kbeckmann/luna/hardware/rev0/luna_rev0.kicad_pcb

## KiCad design hardware/rev0/luna_rev0.kicad_pcb (2020-07-09)

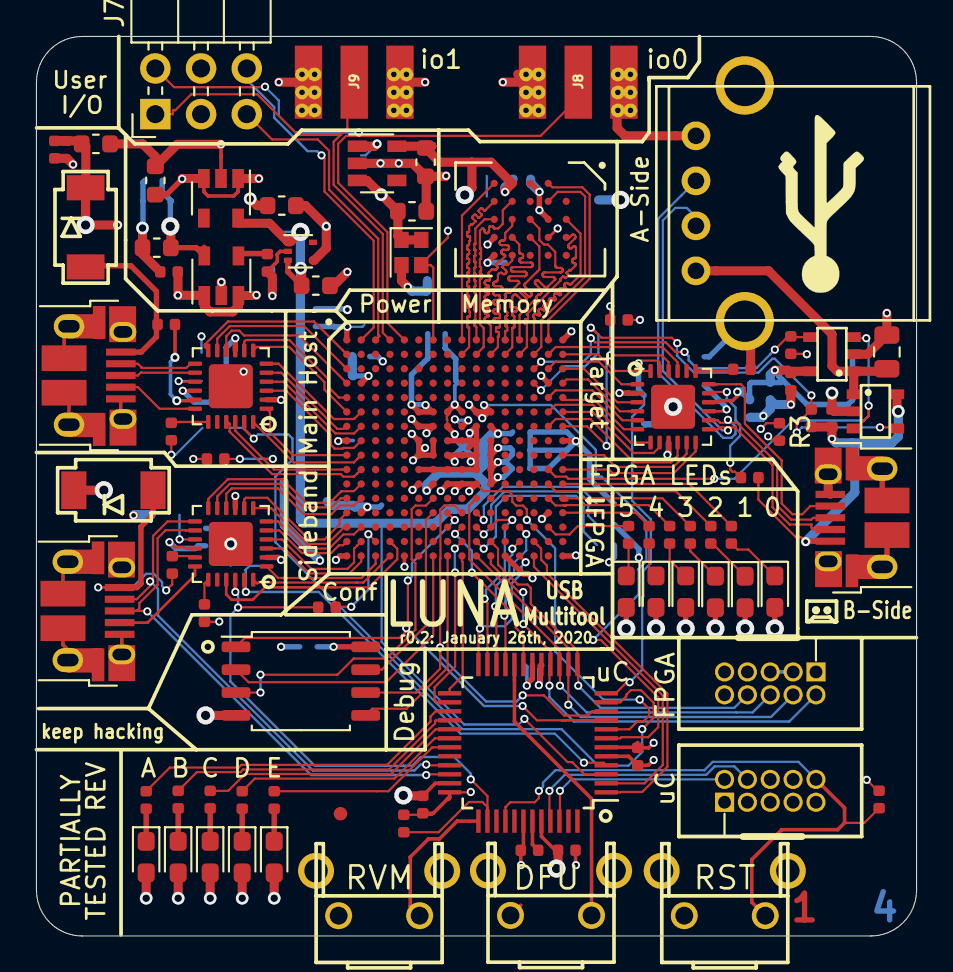
[picture p1: board luna_rev0.kicad_pcb from above]

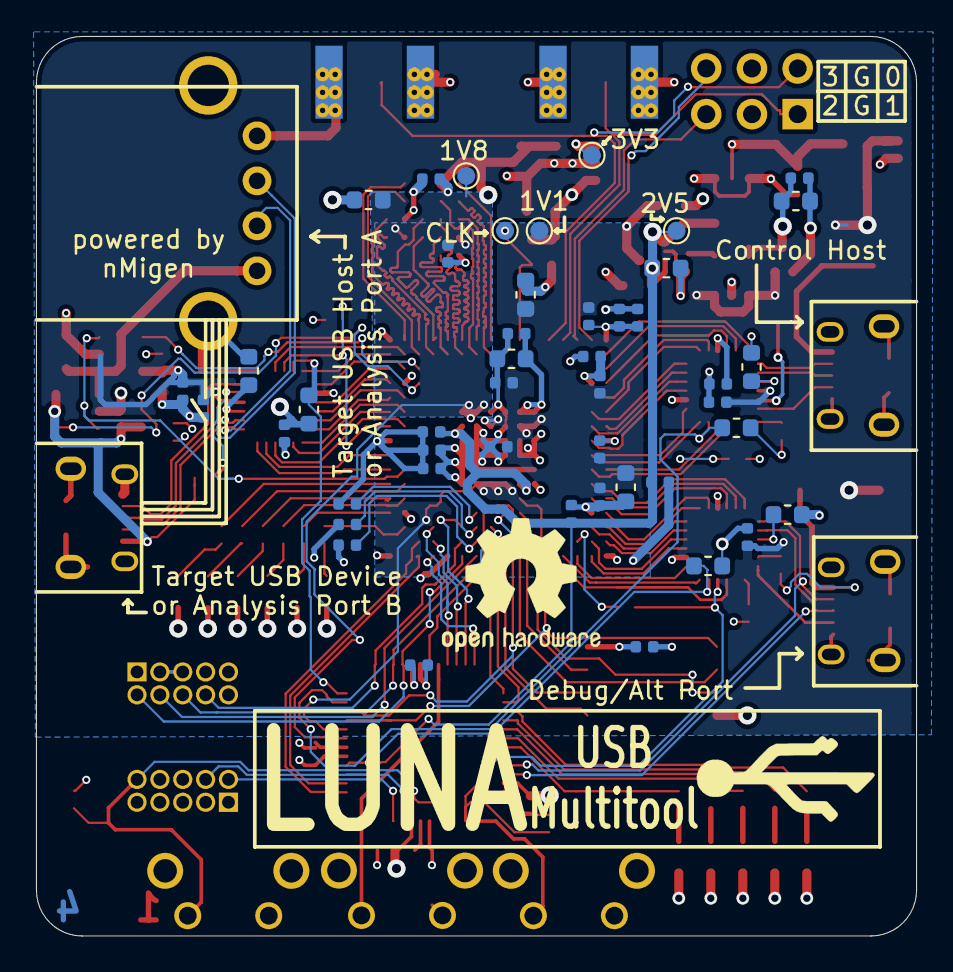
[picture p2: board luna_rev0.kicad_pcb from below]

Board: 4 copper layers, 48.9 x 50.0 mm, 128 parts (46 on the bottom side), 143 nets.

Parts:
C1, C2, C3, C4, C6, C20, C21: 2.2uF; C_0603_1608Metric
C5, C19, C22, C28, C29, C30, C36, C37, C42, C43, C48, C50: 1uF; C_0603_1608Metric
C7, C8, C9, C10, C11, C12, C13, C14, C15, C16, C17, C18, C23, C24, C25, C26, C27, C31, C32, C33, C34, C35, C38, C39, C40, C41, C44, C45, C46, C47, C49, C51, C54, C55: 0.1uF; C_0402_1005Metric
C52: 470pF; C_0402_1005Metric
C53: 10uF; C_0805_2012Metric
D1, D8: PMEG3050EP,115; SOD128
D2: RED; LED_0603_1608Metric_Pad1.05x0.95mm_HandSolder
D3: ORANGE; LED_0603_1608Metric_Pad1.05x0.95mm_HandSolder
D4: YELLOW; LED_0603_1608Metric_Pad1.05x0.95mm_HandSolder
D5: GREEN; LED_0603_1608Metric_Pad1.05x0.95mm_HandSolder
D6, D10, D14: BLUE; LED_0603_1608Metric_Pad1.05x0.95mm_HandSolder
D7: PURPLE; LED_0603_1608Metric_Pad1.05x0.95mm_HandSolder
D11, D13: PINK; LED_0603_1608Metric_Pad1.05x0.95mm_HandSolder
D12: WHITE; LED_0603_1608Metric_Pad1.05x0.95mm_HandSolder
FID: Fiducial_0.75mm_Mask2.25mm
IC1: ECP5-BGA256; lattice_cabga256
J1, J2, J4: USB_B_Micro; USB_Micro-B_Amphenol_10103594-0001LF_Horizontal
J3: USB_A; CONN-Amphenol-UE27AC54100
J5, J6: Conn_ARM_JTAG_SWD_10; SWD_CONNECTOR_LARGE_BOX
J7: Conn_02x02_Counter_Clockwise; PinHeader_2x03_P2.54mm_Horizontal
J8, J9: Conn_Coaxial; SMA-EDGE
R1, R2, R3, R12, R13, R14, R23, R24, R25: 10K; R_0402_1005Metric
R7, R8, R9, R10, R11, R26, R27, R28, R29, R30, R31: 330; R_0402_1005Metric
R15: 1K; R_0402_1005Metric
R16, R18, R20: 8.06k+1%; R_0402_1005Metric
R17, R19, R21: 20K; R_0402_1005Metric
R22: 15K; R_0402_1005Metric
SW1: BTN_RECOVERY; SWITCH-FSMRA
SW2: BTN_DFU; SWITCH-FSMRA
SW3: BTN_RESET; SWITCH-FSMRA
TP1, TP2, TP3, TP4, TP5: TestPoint; TestPoint_Pad_D1.0mm
U1, U12: AP22814-SOT; SOT25
U2: MIC5504-1.8YM5; SOT-23-5
U3: MIC5219-3.3YM5; SOT-23-5
U4: TCR2EE11; SOT-553
U5: MIC5504-2.5YM5; SOT-23-5
U6: ATSAMD21G18A-AUT; TQFP-48_7x7mm_P0.5mm
U7: W25Q32JVSS; SOIC-8_5.23x5.23mm_P1.27mm
U8, U9, U11: USB3343; VQFN-24-1EP_4x4mm_P0.5mm_EP2.45x2.45mm
U10: S27KS0641; BGA-24_5x5_6.0x8.0mm
Y1: DSC60xx; Crystal_SMD_2016-4Pin_2.0x1.6mm

Connections:
+1V1: C1.1, C3.1, C7.1, C9.1, C11.1, C13.1, C15.1, C17.1, C29.1, IC1.G6, IC1.G7, IC1.G9, IC1.L8, IC1.L9, IC1.L10, TP4.1, U4.4, U6.8
+1V8: C19.1, C21.1, C23.1, C25.1, IC1.F10, IC1.F11, TP2.1, U2.5, U6.7, U10.B4, U10.D1, U10.E4
+2V5: C22.1, C24.1, C26.1, C27.1, C30.1, IC1.G11, IC1.L7, TP5.1, U4.1, U4.3, U5.5, U6.3
+3V3: C2.1, C4.1, C5.1, C8.1, C10.1, C12.1, C14.1, C16.1, C18.1, C20.1, C28.1, C31.1, C32.1, C33.1, C34.1, C35.1, C39.1, C41.1, C49.1, D2.2, D3.2, D4.2, D5.2, D6.2, D7.2, D10.2, D11.2, D12.2, D13.2, D14.2, IC1.F6, IC1.F7, IC1.H6, IC1.H7, IC1.H11, IC1.J6, IC1.J7, IC1.J11, IC1.K11, IC1.L6, IC1.L11, J5.1, J6.1, R3.1, R13.2, R22.2, R23.2, R24.2, R25.1, TP3.1, U2.1, U2.3, U3.5, U5.1, U5.3, U6.6, U6.17, U6.36, U6.44, U7.8, U8.2, U8.9, U9.2, U9.9, U11.2, U11.9, Y1.1, Y1.4
+5V: C6.1, C38.1, C40.1, C44.1, C45.1, C46.1, C47.1, C54.1, D1.1, D8.1, U1.5, U3.1, U3.3, U8.16, U9.16, U11.16
/DEBUG_SPI_CIPO: IC1.P11, U6.23
/DEBUG_SPI_CLK: IC1.R13, U6.22
/DEBUG_SPI_COPI: IC1.P13, U6.21
/DEBUG_SPI_CS: IC1.T13, U6.24
/Debug & Control Connections/CLKIN_60MHZ: IC1.A7, TP1.1, Y1.3
/Debug & Control Connections/USER_IO0: IC1.A5, J7.2, J8.1
/Debug & Control Connections/USER_IO1: IC1.A4, J7.1, J9.1
/Debug & Control Connections/USER_IO2: IC1.A3, J7.5
/Debug & Control Connections/USER_IO3: IC1.A2, J7.6
/FORCE_DFU: SW2.2, U6.20
/FORCE_RECOVERY: SW1.2, U6.37
/FPGA Configuration and Dev Features/D0: IC1.T8, U7.5
/FPGA Configuration and Dev Features/D1: IC1.T7, U7.2
/FPGA Configuration and Dev Features/D2: IC1.M7, U7.3
/FPGA Configuration and Dev Features/D3: IC1.N7, U7.7
/FPGA Configuration and Dev Features/FPGA_CFG0: IC1.N10, R12.1
/FPGA Configuration and Dev Features/FPGA_CFG1: IC1.P10, R13.1
/FPGA Configuration and Dev Features/FPGA_CFG2: IC1.R10, R14.1
/FPGA Configuration and Dev Features/FPGA_CONFIG_CLK: IC1.N9, U6.10, U7.6
/FPGA Configuration and Dev Features/FPGA_DONE: IC1.P9, U6.19
/FPGA Configuration and Dev Features/FPGA_TCK: IC1.T10, J5.4, U6.14
/FPGA Configuration and Dev Features/FPGA_TDI: IC1.R11, J5.8, U6.13
/FPGA Configuration and Dev Features/FPGA_TDO: IC1.M10, J5.6, U6.15
/FPGA Configuration and Dev Features/FPGA_TMS: IC1.T11, J5.2, U6.16
/FPGA Configuration and Dev Features/UC_SWDCLK: J6.4, U6.45
/FPGA Configuration and Dev Features/UC_SWDIO: J6.2, U6.46
/FPGA Configuration and Dev Features/~CS_DI: IC1.N8, U6.9, U7.1
/FPGA Configuration and Dev Features/~FPGA_INIT: IC1.T9, U6.25
/FPGA Configuration and Dev Features/~FPGA_PROGRAM: IC1.R9, U6.26
/FULL_RESET: J6.10, R25.2, SW3.2, U6.40
/HOST_D+: J1.3, U11.14
/HOST_D-: J1.2, U11.13
/HOST_ID: J1.4, U11.18
/HOST_PHY_1V8: C50.1, U6.11, U11.23
/Host Section/HOST_DATA0: IC1.G2, U11.4
/Host Section/HOST_DATA1: IC1.G1, U11.5
/Host Section/HOST_DATA2: IC1.F2, U11.6
/Host Section/HOST_DATA3: IC1.F1, U11.7
/Host Section/HOST_DATA4: IC1.E1, U11.8
/Host Section/HOST_DATA5: IC1.D1, U11.10
/Host Section/HOST_DATA6: IC1.C1, U11.11
/Host Section/HOST_DATA7: IC1.B1, U11.12
/Host Section/HOST_DIR: IC1.J1, U11.1
/Host Section/HOST_NXT: IC1.H2, U11.3
/Host Section/HOST_PHY_CLK: IC1.K2, U11.21
/Host Section/HOST_PHY_RESET: IC1.K1, R24.1, U11.22
/Host Section/HOST_STP: IC1.J2, U11.24
/Host Section/HOST_VBUS: D1.2, J1.1, R21.1
/PROVIDE_A_PORT_VBUS: IC1.C14, R1.2, U1.4
/RAM / 1V8 Section/CLK: IC1.B14, U10.B2
/RAM / 1V8 Section/RAM_DQ0: IC1.A11, U10.D3
/RAM / 1V8 Section/RAM_DQ1: IC1.B10, U10.D2
/RAM / 1V8 Section/RAM_DQ2: IC1.B12, U10.C4
/RAM / 1V8 Section/RAM_DQ3: IC1.A12, U10.D4
/RAM / 1V8 Section/RAM_DQ4: IC1.B11, U10.D5
/RAM / 1V8 Section/RAM_DQ5: IC1.A10, U10.E3
/RAM / 1V8 Section/RAM_DQ6: IC1.B9, U10.E2
/RAM / 1V8 Section/RAM_DQ7: IC1.A9, U10.E1
/RAM / 1V8 Section/RAM_RWDS: IC1.A13, U10.C3
/RAM / 1V8 Section/~CLK: IC1.A15, U10.B1
/RAM / 1V8 Section/~CS: IC1.A14, U10.A3
/RAM / 1V8 Section/~RESET: IC1.B13, U10.A4
/Right side indicators/D0: IC1.P15, R31.2
/Right side indicators/D1: IC1.N16, R30.2
/Right side indicators/D2: IC1.M15, R29.2
/Right side indicators/D3: IC1.M16, R28.2
/Right side indicators/D4: IC1.L15, R27.2
/Right side indicators/D5: IC1.L16, R26.2
/SIDEBAND_D+: J2.3, U6.34, U8.14
/SIDEBAND_D-: J2.2, U6.33, U8.13
/SIDEBAND_ID: J2.4, U8.18
/SIDEBAND_PHY_1V8: C37.1, U6.4, U8.23
/SIDEBAND_VBUS: D8.2, J2.1, R17.1
/Sideband Section/SIDEBAND_DATA0: IC1.R2, U8.4
/Sideband Section/SIDEBAND_DATA1: IC1.R1, U8.5
/Sideband Section/SIDEBAND_DATA2: IC1.P2, U8.6
/Sideband Section/SIDEBAND_DATA3: IC1.P1, U8.7
/Sideband Section/SIDEBAND_DATA4: IC1.N1, U8.8
/Sideband Section/SIDEBAND_DATA5: IC1.M2, U8.10
/Sideband Section/SIDEBAND_DATA6: IC1.M1, U8.11
/Sideband Section/SIDEBAND_DATA7: IC1.L2, U8.12
/Sideband Section/SIDEBAND_DIR: IC1.T3, U8.1
/Sideband Section/SIDEBAND_NXT: IC1.T2, U8.3
/Sideband Section/SIDEBAND_PHY_CLK: IC1.R4, U8.21
/Sideband Section/SIDEBAND_STP: IC1.T4, U8.24
/TARGET_D+: J3.3, J4.3, U9.14
/TARGET_D-: J3.2, J4.2, U9.13
/TARGET_FAULT: IC1.K15, R3.2, U1.3, U12.3
/TARGET_ID: J4.4, U9.18
/TARGET_PHY_1V8: C43.1, U6.12, U9.23
/TARGET_VBUS_IN: C55.1, J4.1, R2.2, R19.1, U12.5
/TARGET_VBUS_OUT: C53.2, J3.1, U1.1, U12.1
/Target Section/TARGET_DATA0: IC1.D16, U9.4
/Target Section/TARGET_DATA1: IC1.E15, U9.5
/Target Section/TARGET_DATA2: IC1.E16, U9.6
/Target Section/TARGET_DATA3: IC1.F15, U9.7
/Target Section/TARGET_DATA4: IC1.F16, U9.8
/Target Section/TARGET_DATA5: IC1.G15, U9.10
/Target Section/TARGET_DATA6: IC1.J16, U9.11
/Target Section/TARGET_DATA7: IC1.K16, U9.12
/Target Section/TARGET_PHY_CLK: IC1.B15, U9.21
/Target Section/TARGET_PHY_DIR: IC1.C15, U9.1
/Target Section/TARGET_PHY_NXT: IC1.C16, U9.3
/Target Section/TARGET_PHY_RESET: IC1.G16, R23.1, U9.22
/Target Section/TARGET_PHY_STP: IC1.B16, U9.24
/UC_RX_FPGA_TX: IC1.T14, U6.2
/UC_TX_FPGA_RX: IC1.R14, U6.1
/USB_INHIBIT: R15.1, R22.1, U6.38, U8.22
/VBUS_PASSTHROUGH_EN: IC1.D14, R2.1, U12.4
GND: C1.2, C2.2, C3.2, C4.2, C5.2, C6.2, C7.2, C8.2, C9.2, C10.2, C11.2, C12.2, C13.2, C14.2, C15.2, C16.2, C17.2, C18.2, C19.2, C20.2, C21.2, C22.2, C23.2, C24.2, C25.2, C26.2, C27.2, C28.2, C29.2, C30.2, C31.2, C32.2, C33.2, C34.2, C35.2, C36.2, C37.2, C38.2, C39.2, C40.2, C41.2, C42.2, C43.2, C44.2, C45.2, C46.2, C47.2, C48.2, C49.2, C50.2, C51.2, C52.2, C53.1, C54.2, C55.2, IC1.A1, IC1.A16, IC1.D2, IC1.D15, IC1.F8, IC1.F9, IC1.G8, IC1.G10, IC1.H1, IC1.H8, IC1.H9, IC1.H10, IC1.H16, IC1.J8, IC1.J9, IC1.J10, IC1.K6, IC1.K7, IC1.K8, IC1.K9, IC1.K10, IC1.N2, IC1.N15, IC1.T1, IC1.T5, IC1.T12, IC1.T16, J1.5, J1.6, J2.5, J2.6, J3.4, J3.5, J4.5, J4.6, J5.3, J5.5, J5.9, J6.3, J6.5, J6.9, J7.3, J7.4, J8.2, J9.2, R1.1, R12.2, R14.2, R16.1, R18.1, R20.1, SW1.1, SW2.1, SW3.1, U1.2, U2.2, U3.2, U4.2, U5.2, U6.5, U6.18, U6.35, U6.42, U7.4, U8.25, U9.25, U10.B3, U10.C1, U10.E5, U11.25, U12.2, Y1.2
unnamed: C36.1, U8.15
unnamed: C42.1, U9.15
unnamed: C48.1, U11.15
unnamed: C51.1, U6.43
unnamed: C52.1, U3.4
unnamed: D2.1, R26.1
unnamed: D3.1, R27.1
unnamed: D4.1, R28.1
unnamed: D5.1, R29.1
unnamed: D6.1, R30.1
unnamed: D7.1, R31.1
unnamed: D10.1, R7.1
unnamed: D11.1, R8.1
unnamed: D12.1, R9.1
unnamed: D13.1, R10.1
unnamed: D14.1, R11.1
unnamed: IC1.R3, R15.2
unnamed: R7.2, U6.27
unnamed: R8.2, U6.28
unnamed: R9.2, U6.29
unnamed: R10.2, U6.30
unnamed: R11.2, U6.31
unnamed: R16.2, U8.19
unnamed: R17.2, U8.17
unnamed: R18.2, U9.19
unnamed: R19.2, U9.17
unnamed: R20.2, U11.19
unnamed: R21.2, U11.17
