kbeckmann/luna/luna/gateware/applets/analyzer.py

#!/usr/bin/env python3
# pylint: disable=maybe-no-member
#
# This file is part of LUNA.
#
# Copyright (c) 2020 Great Scott Gadgets <info@greatscottgadgets.com>
# SPDX-License-Identifier: BSD-3-Clause

""" Generic USB analyzer backend generator for LUNA. """

import time
import errno


import usb
from datetime import datetime

from nmigen                           import Signal, Elaboratable, Module
from usb_protocol.emitters            import DeviceDescriptorCollection

from luna                             import get_appropriate_platform
from luna.usb2                        import USBDevice, USBStreamInEndpoint

from luna.gateware.utils.cdc          import synchronize
from luna.gateware.architecture.car   import LunaECP5DomainGenerator

from luna.gateware.interface.ulpi     import UTMITranslator
from luna.gateware.usb.analyzer       import USBAnalyzer

# Temporary.
from luna.apollo                      import ApolloDebugger
from luna.gateware.interface.uart     import UARTTransmitter


USB_SPEED_HIGH       = 0b00
USB_SPEED_FULL       = 0b01
USB_SPEED_LOW        = 0b10

USB_VENDOR_ID        = 0x1d50
USB_PRODUCT_ID       = 0x615b

BULK_ENDPOINT_NUMBER  = 1
BULK_ENDPOINT_ADDRESS = 0x80 | BULK_ENDPOINT_NUMBER
MAX_BULK_PACKET_SIZE  = 512

class USBAnalyzerApplet(Elaboratable):
    """ Gateware that serves as a generic USB analyzer backend.

    WARNING: This is _incomplete_! It's missing:
        - DRAM backing for analysis
    """


    def __init__(self, usb_speed=USB_SPEED_FULL):
        self.usb_speed = usb_speed


    def create_descriptors(self):
        """ Create the descriptors we want to use for our device. """

        descriptors = DeviceDescriptorCollection()

        #
        # We'll add the major components of the descriptors we we want.
        # The collection we build here will be necessary to create a standard endpoint.
        #

        # We'll need a device descriptor...
        with descriptors.DeviceDescriptor() as d:
            d.idVendor           = USB_VENDOR_ID
            d.idProduct          = USB_PRODUCT_ID

            d.iManufacturer      = "LUNA"
            d.iProduct           = "USB Analyzer"
            d.iSerialNumber      = "[autodetect serial here]"

            d.bNumConfigurations = 1


        # ... and a description of the USB configuration we'll provide.
        with descriptors.ConfigurationDescriptor() as c:

            with c.InterfaceDescriptor() as i:
                i.bInterfaceNumber = 0

                with i.EndpointDescriptor() as e:
                    e.bEndpointAddress = BULK_ENDPOINT_ADDRESS
                    e.wMaxPacketSize   = MAX_BULK_PACKET_SIZE


        return descriptors


    def elaborate(self, platform):
        m = Module()

        # Generate our clock domains.
        clocking = LunaECP5DomainGenerator()
        m.submodules.clocking = clocking

        # Create our UTMI translator.
        ulpi = platform.request("target_phy")
        m.submodules.utmi = utmi = UTMITranslator(ulpi=ulpi)

        # Strap our power controls to be in VBUS passthrough by default,
        # on the target port.
        m.d.comb += [
            platform.request("power_a_port")      .eq(0),
            platform.request("pass_through_vbus") .eq(1),
        ]

        # Set up our parameters.
        m.d.comb += [

            # Set our mode to non-driving and to the desired speed.
            utmi.op_mode     .eq(0b01),
            utmi.xcvr_select .eq(self.usb_speed),

            # Disable all of our terminations, as we want to participate in
            # passive observation.
            utmi.dm_pulldown .eq(0),
            utmi.dm_pulldown .eq(0),
            utmi.term_select .eq(0)
        ]

        # Create our USB uplink interface...
        uplink_ulpi = platform.request("host_phy")
        m.submodules.usb = usb = USBDevice(bus=uplink_ulpi)

        # Add our standard control endpoint to the device.
        descriptors = self.create_descriptors()
        usb.add_standard_control_endpoint(descriptors)

        # Add a stream endpoint to our device.
        stream_ep = USBStreamInEndpoint(
            endpoint_number=BULK_ENDPOINT_NUMBER,
            max_packet_size=MAX_BULK_PACKET_SIZE
        )
        usb.add_endpoint(stream_ep)

        # Create a USB analyzer, and connect a register up to its output.
        m.submodules.analyzer = analyzer = USBAnalyzer(utmi_interface=utmi)

        m.d.comb += [
            # USB stream uplink.
            stream_ep.stream            .connect(analyzer.stream),

            usb.connect                 .eq(1),

            # LED indicators.
            platform.request("led", 0)  .eq(analyzer.capturing),
            platform.request("led", 1)  .eq(analyzer.stream.valid),
            platform.request("led", 2)  .eq(analyzer.overrun),

            platform.request("led", 3)  .eq(utmi.session_valid),
            platform.request("led", 4)  .eq(utmi.rx_active),
            platform.request("led", 5)  .eq(utmi.rx_error),
        ]

        # Return our elaborated module.
        return m



class USBAnalyzerConnection:
    """ Class representing a connection to a LUNA USB analyzer.

    This abstracts away connection details, so we can rapidly change the way things
    work without requiring changes in e.g. our ViewSB frontend.
    """

    def __init__(self):
        """ Creates our connection to the USBAnalyzer. """

        self._buffer = bytearray()
        self._device = None



    def build_and_configure(self, capture_speed):
        """ Builds the LUNA analyzer applet and configures the FPGA with it. """

        # Create the USBAnalyzer we want to work with.
        analyzer = USBAnalyzerApplet(usb_speed=capture_speed)

        # Build and upload the analyzer.
        # FIXME: use a temporary build directory
        platform = get_appropriate_platform()
        platform.build(analyzer, do_program=True)

        time.sleep(3)

        # For now, we'll use a slow, synchronous connection to the device via pyusb.
        # This should be replaced with libusb1 for performance.
        while not self._device:

            # FIXME: add timeout
            self._device = usb.core.find(idVendor=USB_VENDOR_ID, idProduct=USB_PRODUCT_ID)


    def _fetch_data_into_buffer(self):
        """ Attempts a single data read from the analyzer into our buffer. """

        try:
            data = self._device.read(BULK_ENDPOINT_ADDRESS, MAX_BULK_PACKET_SIZE)
            self._buffer.extend(data)
        except usb.core.USBError as e:
            if e.errno == errno.ETIMEDOUT:
                pass
            else:
                raise



    def read_raw_packet(self):
        """ Reads a raw packet from our USB Analyzer. Blocks until a packet is complete.

        Returns: packet, timestamp, flags:
            packet    -- The raw packet data, as bytes.
            timestamp -- The timestamp at which the packet was taken, in microseconds.
            flags     -- Flags indicating connection status. Format TBD.
        """

        size = 0
        packet = None

        # Read until we get enough data to determine our packet's size...
        while not packet:
            while len(self._buffer) < 3:
                self._fetch_data_into_buffer()

            # Extract our size from our buffer.
            size = (self._buffer.pop(0) << 8) | self._buffer.pop(0)

            # ... and read until we have a packet.
            while len(self._buffer) < size:
                self._fetch_data_into_buffer()

            # Extract our raw packet...
            packet = self._buffer[0:size]
            del self._buffer[0:size]


        # ... and return it.
        # TODO: extract and provide status flags
        # TODO: generate a timestamp on-device
        return packet, datetime.now(), None
