kbeckmann/luna/firmware/apollo/src/boards/pergola/debug_spi.c

/**
 * Interface code for communicating with the FPGA over the Debug SPI connection.
 *
 * This file is part of LUNA.
 *
 * Copyright (c) 2020 Great Scott Gadgets <info@greatscottgadgets.com>
 * Copyright (c) 2020 Konrad Beckmann
 * SPDX-License-Identifier: BSD-3-Clause
 */

#include <tusb.h>
#include <apollo_board.h>


/**
 * Request that sends a block of data over our debug SPI.
 */
bool handle_flash_spi_send(uint8_t rhport, tusb_control_request_t const* request)
{
	// Daisho doesn't support this, due to lack of flash.
	return false;
}


bool handle_flash_spi_send_complete(uint8_t rhport, tusb_control_request_t const* request)
{
	// Daisho doesn't support this, due to lack of flash.
	return false;
}
