kbeckmann/luna/firmware/apollo/src/boards/pergola/tusb_config.h

/*
 * The MIT License (MIT)
 *
 * Copyright (c) 2019 Ha Thach (tinyusb.org)
 *
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
 */

#ifndef _TUSB_CONFIG_H_
#define _TUSB_CONFIG_H_

#ifdef __cplusplus
 extern "C" {
#endif

//--------------------------------------------------------------------
// COMMON CONFIGURATION
//--------------------------------------------------------------------

// defined by compiler flags for flexibility
#ifndef CFG_TUSB_MCU
  #error CFG_TUSB_MCU must be defined
#endif

#define CFG_TUSB_RHPORT0_MODE       OPT_MODE_DEVICE
#define CFG_TUSB_OS                 OPT_OS_NONE

/* USB DMA on some MCUs can only access a specific SRAM region with restriction on alignment.
 * Tinyusb use follows macros to declare transferring memory so that they can be put
 * into those specific section.
 * e.g
 * - CFG_TUSB_MEM SECTION : __attribute__ (( section(".usb_ram") ))
 * - CFG_TUSB_MEM_ALIGN   : __attribute__ ((aligned(4)))
 */
#ifndef CFG_TUSB_MEM_SECTION
#define CFG_TUSB_MEM_SECTION
#endif

#ifndef CFG_TUSB_MEM_ALIGN
#define CFG_TUSB_MEM_ALIGN          __attribute__ ((aligned(4)))
#endif

//--------------------------------------------------------------------
// DEVICE CONFIGURATION
//--------------------------------------------------------------------
#ifndef CFG_TUD_ENDPOINT0_SIZE
#define CFG_TUD_ENDPOINT0_SIZE    64
#endif


//------------- CLASS -------------//
#define CFG_TUD_CDC              1
#define CFG_TUD_DFU_RT           1
#define CFG_TUD_VENDOR           1

// CDC FIFO size of TX and RX
#define CFG_TUD_VENDOR_RX_BUFSIZE   16
#define CFG_TUD_VENDOR_TX_BUFSIZE   512


// CDC FIFO size of TX and RX
#define CFG_TUD_CDC_RX_BUFSIZE   64
#define CFG_TUD_CDC_TX_BUFSIZE   64



#ifdef __cplusplus
 }
#endif

#endif /* _TUSB_CONFIG_H_ */
