kbeckmann/luna/(commit log)

2020-05-21 Update version and add gerbers
    [luna_rev0-B_Cu.gbl, luna_rev0-B_Mask.gbs, luna_rev0-B_Paste.gbp, luna_rev0-B_SilkS.gbo, luna_rev0-Edge_Cuts.gm1, luna_rev0-F_Cu.gtl, luna_rev0-F_Mask.gts, luna_rev0-F_Paste.gtp]
2020-06-28 Add sigrok trace of failed enumeration
2020-07-02 Add traces
2020-07-02 Swap clocks
    Works worse/not at all now. But at least it's the same as orange crab.
    [pergola.py]
2020-07-09 apollo: move to using the OpenMoko VID/PID for Apollo
2020-07-09 platform.lambdaconcept: add ECPIX-5 as a supported board
2020-07-09 hardware: adopt OSHWA convention for SPI signal names
    https://www.oshwa.org/a-resolution-to-redefine-spi-signal-names
    [luna_rev0.kicad_pcb, luna_rev0.sch, right_side_indicators.sch]
2020-07-09 gateware.usb: add a premade CDC-ACM device type
2020-07-09 gateware.platform: orangecrab fixes and iCEBreaker unofficial platform
    [icebreaker.py, orangecrab.py, tinyfpga.py]
2020-07-09 gateware.platform: correctly constrain iCEBreaker clocks
    [icebreaker.py]
2020-07-12 pergola: Add basic uart support
