kbeckmann/luna/(notices)

Notices in the files:
hardware/rev0/right_side_indicators.sch:
Licensed under the CERN-OHL-P v2
hardware/rev0/luna_rev0.sch:
Copyright 2019-2020 Great Scott Gadgets
